a-shafir/spectropak/hvamp_proto/gerber/spectroamp1-drl_map.dxf

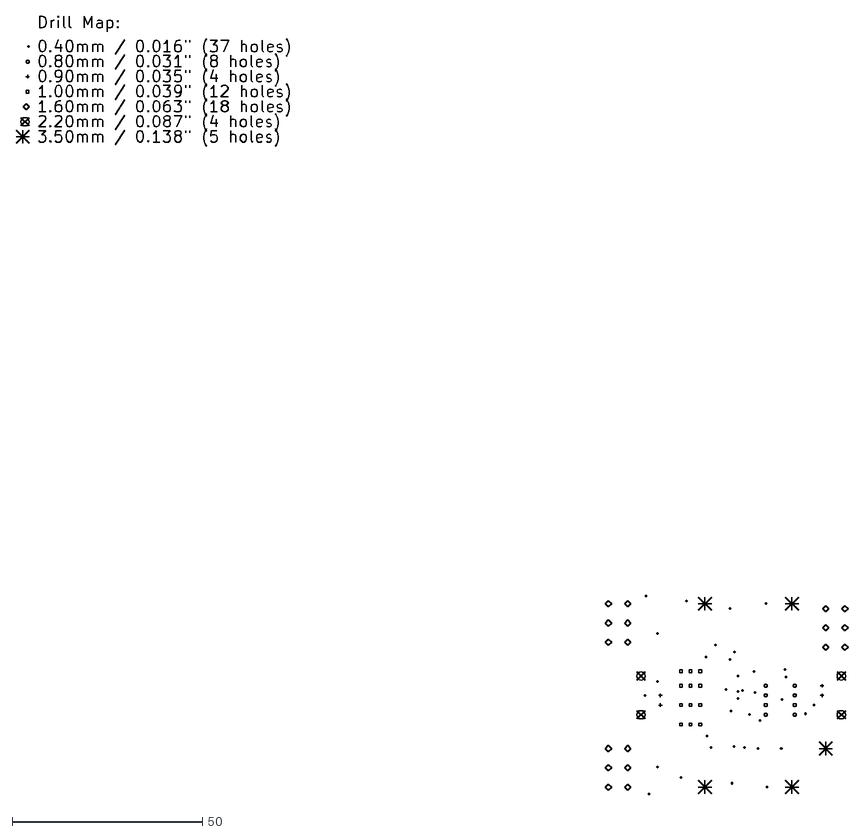
[picture p1: CAD file, 2017-10-07]
hvamp_proto/gerber/spectroamp1-drl_map.dxf
218.9 x 204.8
