a-shafir/spectropak/hvamp_proto3/spectroamp3.pdf

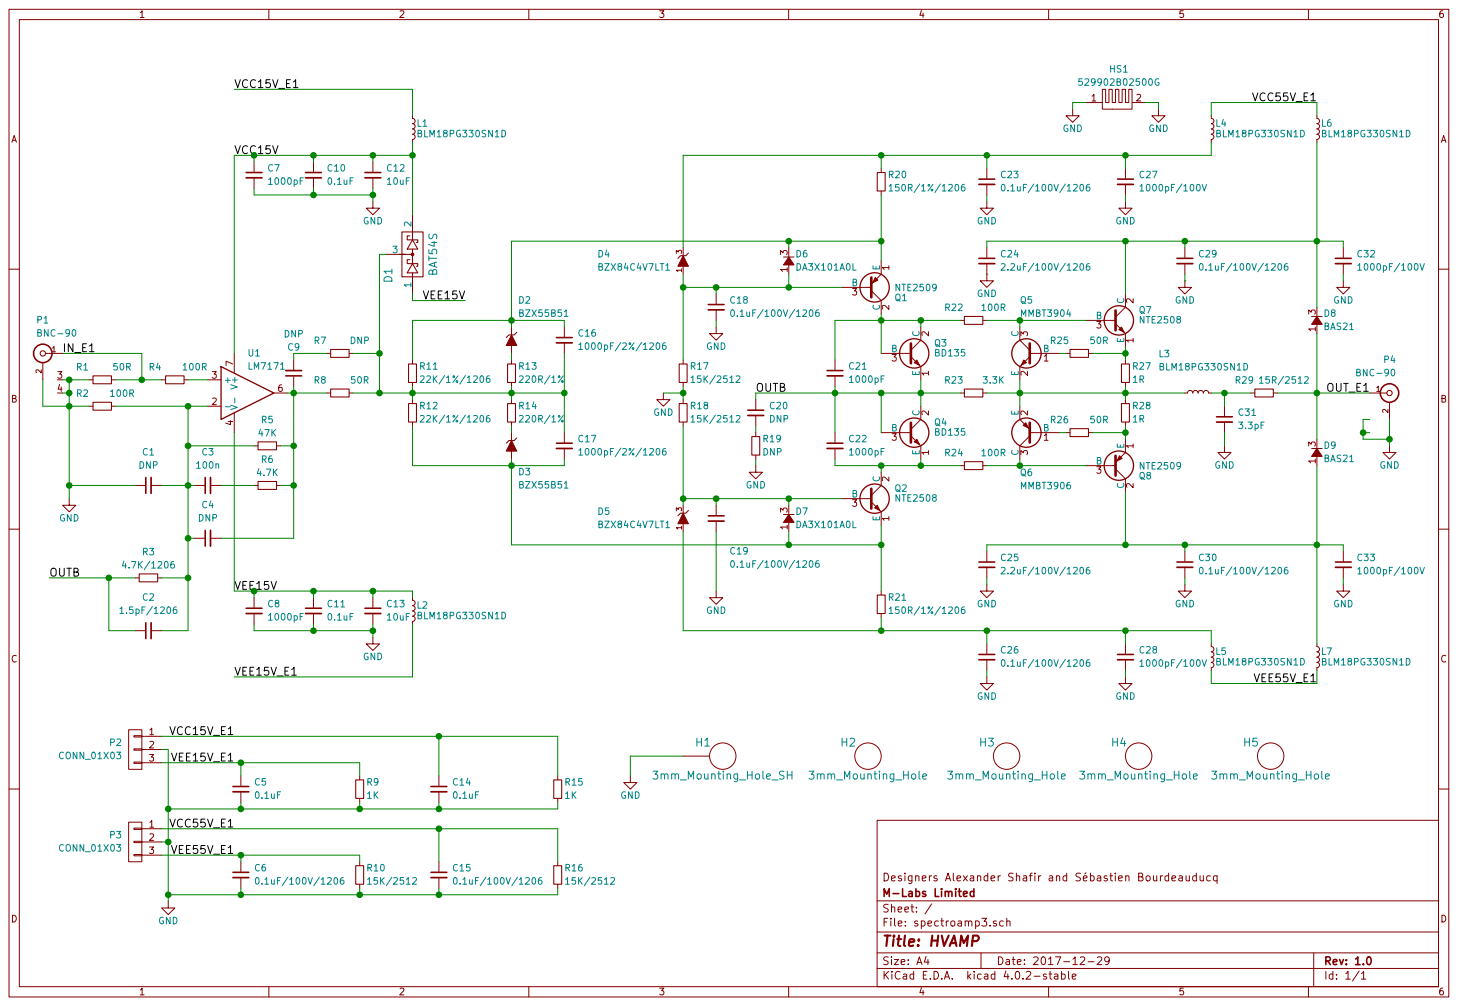
[picture p2: page 1]

File: spectroamp3.sch Sheet: / M-Labs Limited Designers Alexander Shafir and Sébastien Bourdeauducq
