a-shafir/spectropak/hvamp_proto2/spectroamp2val2.pdf

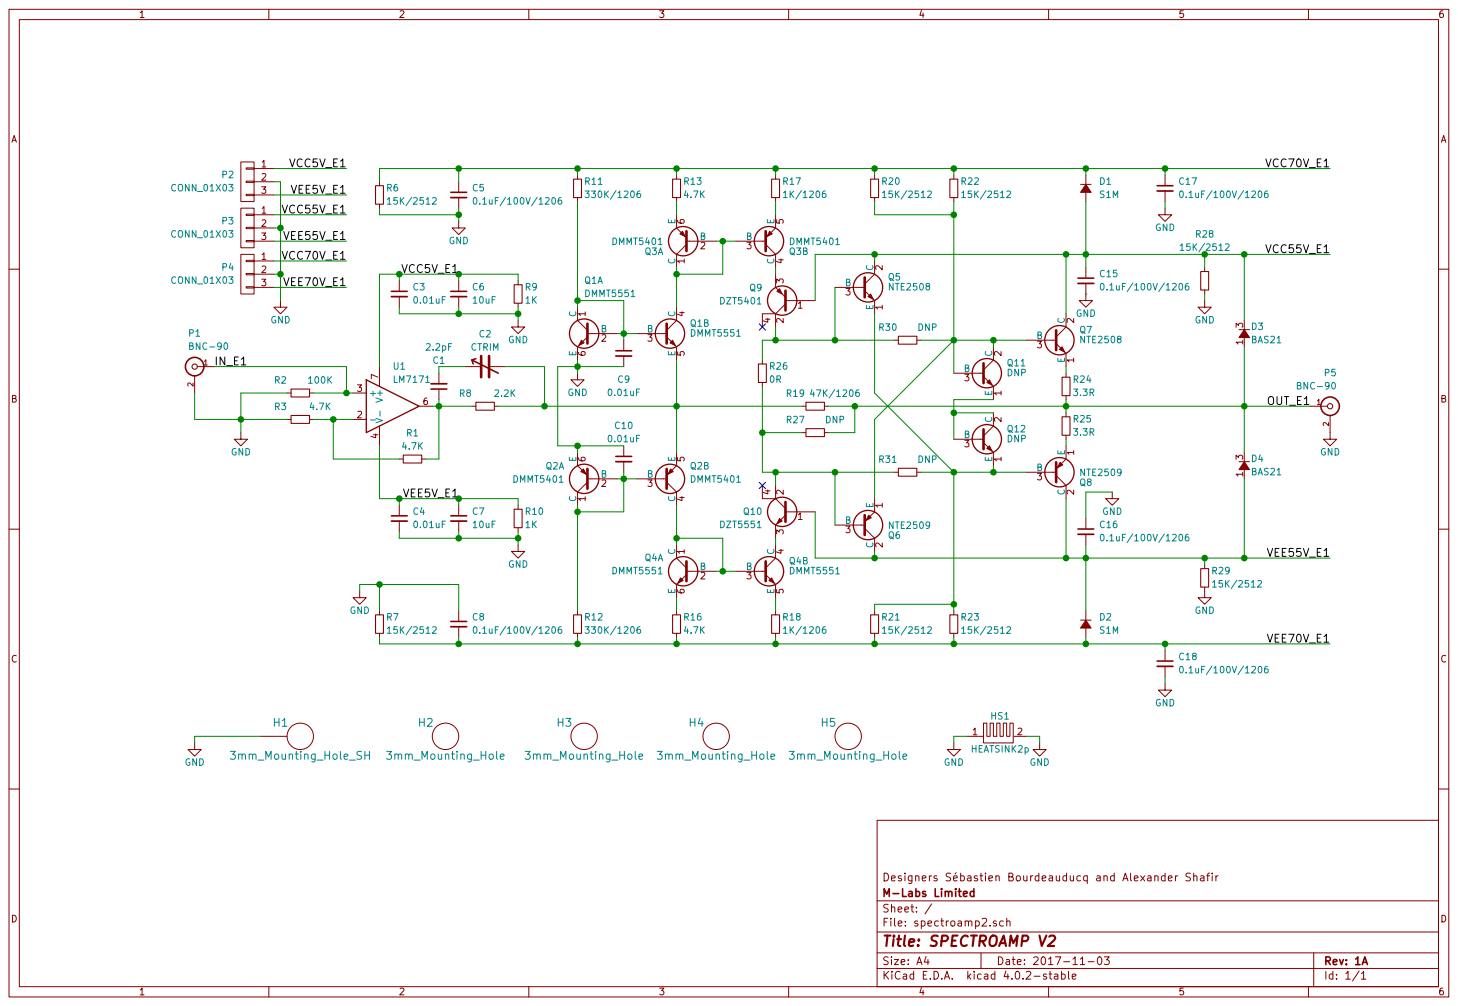
[picture p3: page 1]

File: spectroamp2.sch Sheet: / M-Labs Limited Designers Sébastien Bourdeauducq and Alexander Shafir
