a-shafir/spectropak/hvamp_proto/spectroamp1.pdf

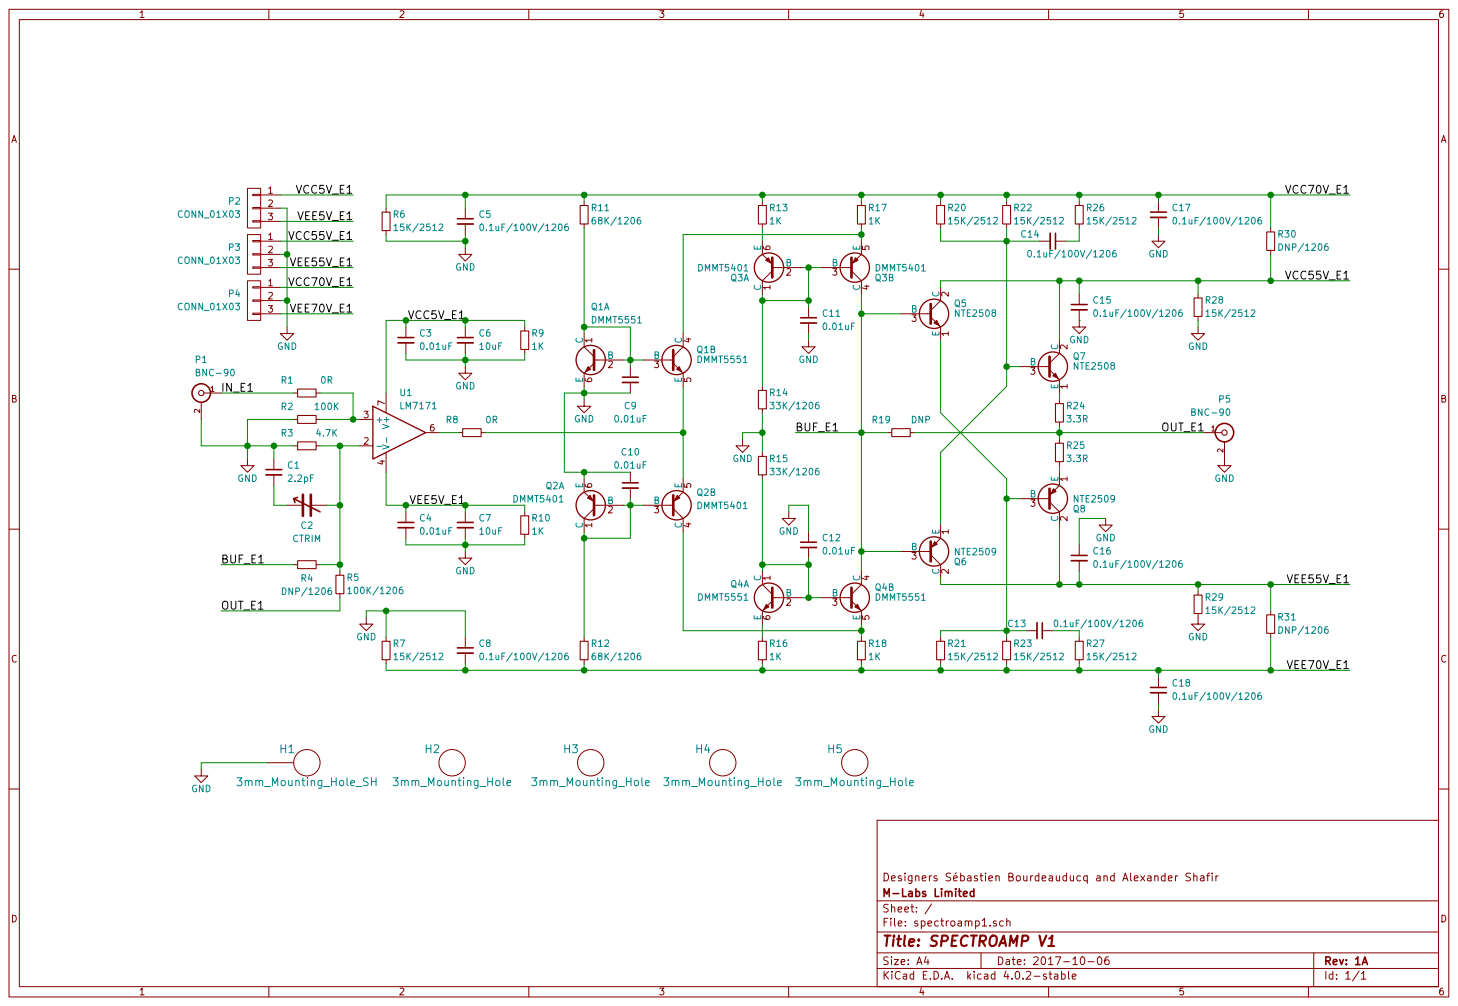
[picture p4: page 1]

File: spectroamp1.sch Sheet: / M-Labs Limited Designers Sébastien Bourdeauducq and Alexander Shafir
