a-shafir/spectropak/hvamp_proto3/sim/hvamp_v1_bw.pdf

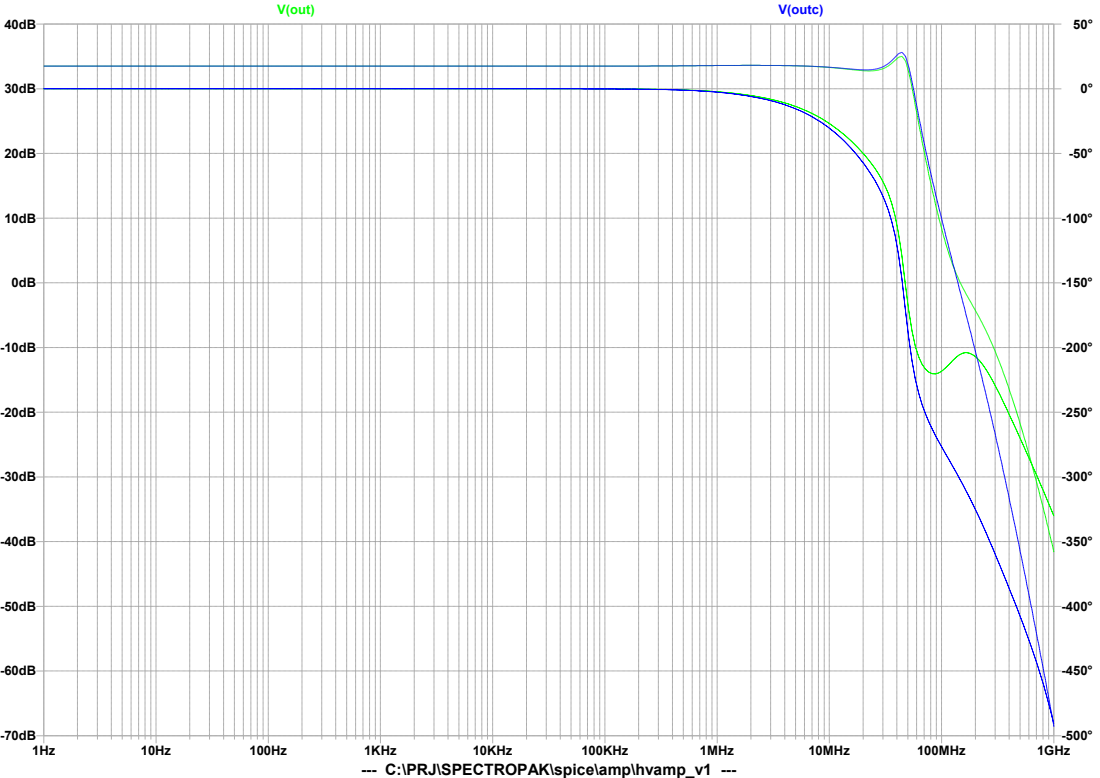
[picture p6: page 1]
1KHz; 10KHz; 100KHz; 1MHz; 10MHz; 100MHz; 1GHz; V(out); V(outc)

--- C:\PRJ\SPECTROPAK\spice\amp\hvamp_v1 ---
