a-shafir/spectropak/hvamp_proto3/sim/hvamp_v1_fft_20M.pdf

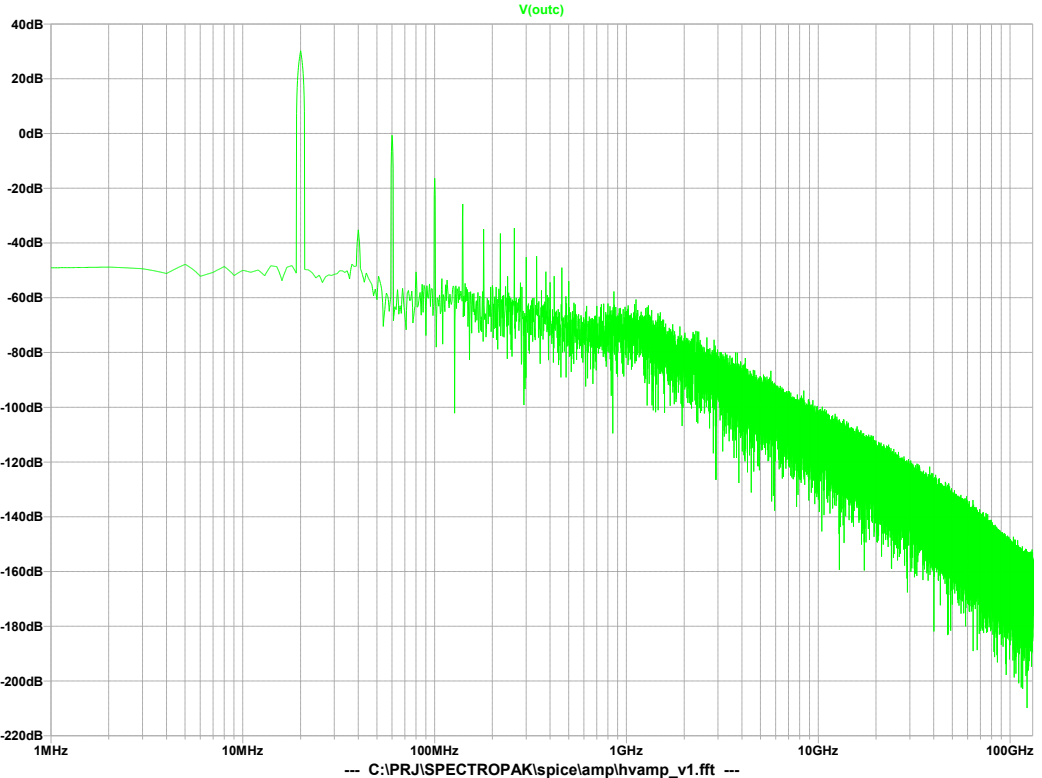
[picture p7: page 1]
1MHz; 10MHz; 100MHz; 1GHz; 10GHz; 100GHz; V(outc)

--- C:\PRJ\SPECTROPAK\spice\amp\hvamp_v1.fft ---
