a-shafir/spectropak/hvamp_proto3/sim/hvamp_v1.asc

C1: cap; 1n
C2: cap; 1µ
C3: cap; 0p
C4: cap; 1n
C5: cap; 0.1p
C6: cap; 0.1p
C7: cap; 2p
C8: cap; 2.2µF
C9: cap; 1n
C10: cap; 1.5p
C11: cap; 50p
C12: cap; 1n
C13: cap; 1n
C14: cap; 5pf
C15: cap; 0
D1: zener; TDZ47B
D2: schottky; BAT54
D3: zener; TDZ47B
D4: schottky; BAT54
D5: diode; 1N4148
D7: diode; 1N4148
L1: FerriteBead; 3.2n; Ipk=2 Rser=0.064 Rpar=620 Cpar=1.1p mfg="Würth Elektronik" pn="782763621 WE-CBA 1206"
Q1: npn; NTE2508
Q2: pnp; NTE2509
Q3: npn; NTE2508
Q4: npn; NTE2508
Q5: npn; NTE2508
Q6: pnp; NTE2509
R1: res; 220
R2: res; 470K
R3: res; 50
R4: res; 220
R5: res; 4.7K
R6: res; 100
R7: res; 15K
R8: res; 15K
R9: res; 4.7K
R10: res; 150
R11: res; 150
R12: res; 1
R13: res; 1
R14: res; 3.3K
R15: res; 15
R17: res; 100
R18: res; 100
R19: res; 100
R20: res; 0.1
R21: res; 1K
U1: LM7171A
V1: voltage; 4V
V2: voltage; -51.5
V3: voltage; SINE(0 1 20meg 990u); AC 1
V4: voltage; 51.5
V5: voltage; -4
V6: voltage; 15
V7: voltage; 15
V8: voltage; SINE(0); AC 0
Named nets: 0, IN, OUT, OUTC, OUTB, oo
.measure tmp max mag(V(out))
.measure BW trig mag(V(out))=tmp/sqrt(2) rise=1 targ mag(V(out))=tmp/sqrt(2) fall=last
.model NTE2508 NPN(IS=5.80f BF=120 NF=0.98 VAF=23.0 IKF=4 ISE=70.0f NE=1.70 BR=1.40 NR=1.00 VAR=38.0 IKR=20 ISC=10f NC=1.50 RB=360m IRB=1 RBM=80m RE=60m RC=180.0m XTB=0 XTI=3 EG=1.11 NK=0.68 CJC=6.7p FC=0.5 MJC=0.33 VJC=0.75 MJE=0.33 VJE=0.75 CJE=15p TF=400p ITF=1 XTF=10 VTF=20 MFG=SANYO)
.model NTE2509 PNP(IS=5.80f BF=120 NF=0.98 VAF=23.0 IKF=4 ISE=70.0f NE=1.70 BR=1.40 NR=1.00 VAR=38.0 IKR=20 ISC=10f NC=1.50 RB=360m IRB=1 RBM=80m RE=60m RC=180.0m XTB=0 XTI=3 EG=1.11 NK=0.68 CJC=6.7p FC=0.5 MJC=0.33 VJC=0.75 MJE=0.33 VJE=0.75 CJE=15p TF=400p ITF=1 XTF=10 VTF=20 MFG=SANYO)
.model NTE2508A NPN(BF=120)
.model NTE2509A PNP(BF=120)
.model TDZ47B D(Is=4.5055E-15 N=1.0301 Rs=94.841E-3 Ikf=14.702 Cjo=115.20E-12 M=.33266 Vj=.8018 Isr=30.417E-12 Bv=51 Ibv=10.000E-3 tt=520.81E-9 Nbv=0.3 Tbv1=0.00102 Vpk=30 mfg=Rohm type=Zener)
.tran 0 1m 999u uic
.fourier 20Meg V(OUT)
;.ac oct 10 1 1000Meg
