a-shafir/spectropak/(commit log)

2017-10-07 add hvamp prototype design
    [spectroamp1-B.Cu.gbr, spectroamp1-B.Mask.gbr, spectroamp1-F.Cu.gbr, spectroamp1-F.Mask.gbr, spectroamp1-F.SilkS.gbr, spectroamp1-In1.Cu.gbr, spectroamp1-In2.Cu.gbr, spectroamp1-Margin.gbr]
2017-11-06 add hvamp rev2 gerbers
    [spectroamp2-B.Cu.gbl, spectroamp2-B.Mask.gbs, spectroamp2-B.SilkS.gbo, spectroamp2-F.Cu.gtl, spectroamp2-F.Mask.gts, spectroamp2-F.SilkS.gto, spectroamp2-Margin.gbr, spectroamp2.drl]
2017-11-06 add hvamp rev2 PDF schematics
2017-12-29 add hvamp3 proto design files
    [spectroamp3-B.Cu.gbl, spectroamp3-B.Mask.gbs, spectroamp3-B.SilkS.gbo, spectroamp3-F.Cu.gtl, spectroamp3-F.Mask.gts, spectroamp3-F.SilkS.gto, spectroamp3-Margin.gbr, spectroamp3.drl]
